Gninnorg/Gninnorg-Mezmerize-B1-ESP32-Controller/hardware/3D-front.jpg

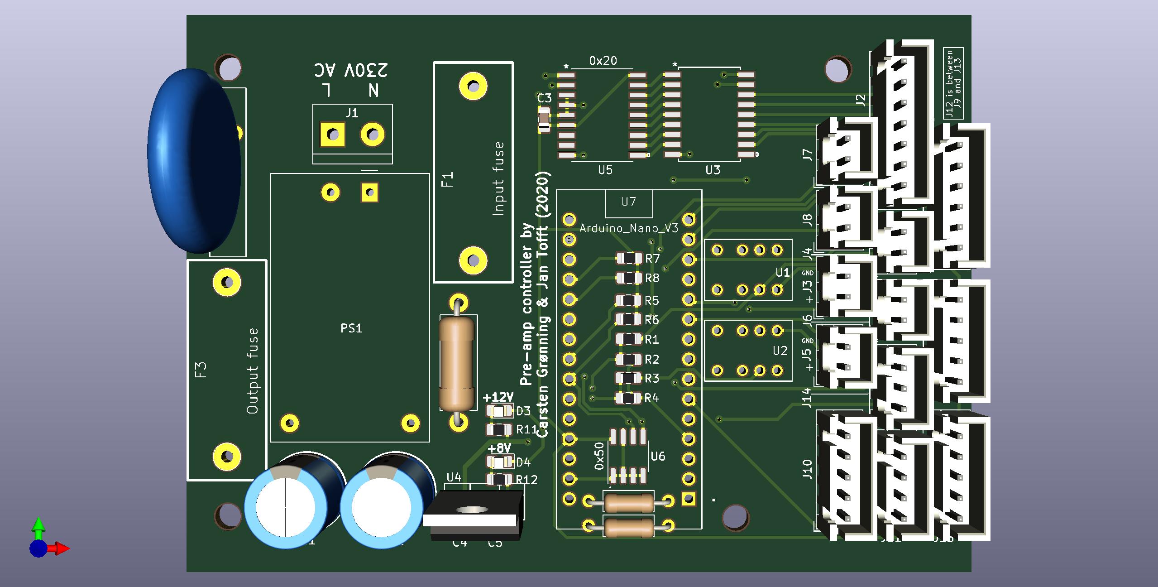
hardware/3D-front.jpg
