Gninnorg/Gninnorg-Mezmerize-B1-ESP32-Controller/hardware/3D-back.jpg

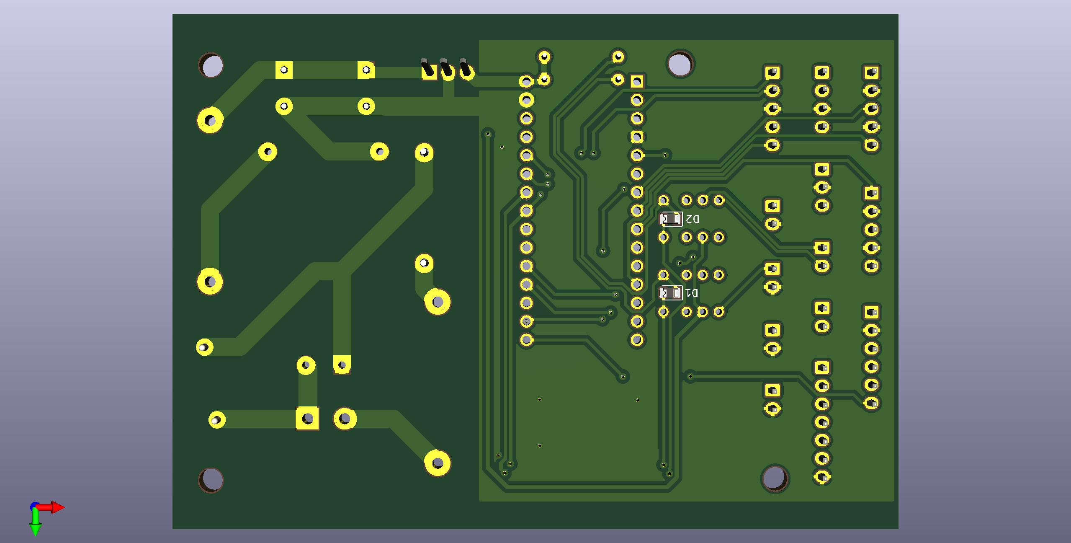
hardware/3D-back.jpg
