Gninnorg/Gninnorg-Mezmerize-B1-ESP32-Controller/hardware/BOM.xlsx

ref | value5 | footprint
C1 | 470uF | Capacitor_THT:CP_Radial_D10.0mm_P5.00mm
C2 | 470uF | Capacitor_THT:CP_Radial_D10.0mm_P5.00mm
C3 | 0.1uF | Capacitor_SMD:C_0805_2012Metric_Pad1.15x1.40mm_HandSolder
C4 | 0.33uF | Capacitor_SMD:C_0805_2012Metric_Pad1.15x1.40mm_HandSolder
C5 | 0.1uF | Capacitor_SMD:C_0805_2012Metric_Pad1.15x1.40mm_HandSolder
F1 | Fuse 200mA | Fuse:Fuseholder_Cylinder-5x20mm_Schurter_0031_8201_Horizontal_Open
F2 | Thermal fuse 73dgr | Resistor_THT:R_Axial_DIN0414_L11.9mm_D4.5mm_P15.24mm_Horizontal
F3 | Fuse 600mA T | Fuse:Fuseholder_Cylinder-5x20mm_Schurter_0031_8201_Horizontal_Open
J1 | 230 Vac | TerminalBlock:TerminalBlock_bornier-2_P5.08mm
J2 | B1 Relays | Connector_PinHeader_2.54mm:PinHeader_1x07_P2.54mm_Vertical
J3 | PWR AMP L 12V TRIGGER | Connector_PinHeader_2.54mm:PinHeader_1x02_P2.54mm_Vertical
J4 | PWR AMP L SWITCH | Connector_PinHeader_2.54mm:PinHeader_1x02_P2.54mm_Vertical
J5 | PWR AMP R 12V TRIGGER | Connector_PinHeader_2.54mm:PinHeader_1x02_P2.54mm_Vertical
J6 | PWR AMP R SWITCH | Connector_PinHeader_2.54mm:PinHeader_1x02_P2.54mm_Vertical
J7 | PWR AMP TEMP NTC L | Connector_PinHeader_2.54mm:PinHeader_1x02_P2.54mm_Vertical
J8 | PWR AMP TEMP NTC R | Connector_PinHeader_2.54mm:PinHeader_1x02_P2.54mm_Vertical
J9 | MUSES 72320 (SPI) | Connector_PinHeader_2.54mm:PinHeader_1x06_P2.54mm_Vertical
J10 | I2C DISPLAY (OLED/LCD) | Connector_PinHeader_2.54mm:PinHeader_1x05_P2.54mm_Vertical
J11 | I2C (FUTURE USE) | Connector_PinHeader_2.54mm:PinHeader_1x04_P2.54mm_Vertical
J12 | ROTARY ENC & SWITCH (FUTURE USE) | Connector_PinHeader_2.54mm:PinHeader_1x05_P2.54mm_Vertical
J13 | ROTARY ENC & SWITCH | Connector_PinHeader_2.54mm:PinHeader_1x05_P2.54mm_Vertical
J14 | IR RECV | Connector_PinHeader_2.54mm:PinHeader_1x03_P2.54mm_Vertical
PS1 | HLK-PM12 | Converter_ACDC:Converter_ACDC_HiLink_HLK-PMxx
R1 | 10K | Resistor_SMD:R_0805_2012Metric_Pad1.15x1.40mm_HandSolder
R2 | 5K | Resistor_SMD:R_0805_2012Metric_Pad1.15x1.40mm_HandSolder
R3 | 10K | Resistor_SMD:R_0805_2012Metric_Pad1.15x1.40mm_HandSolder
R4 | 5K | Resistor_SMD:R_0805_2012Metric_Pad1.15x1.40mm_HandSolder
R5 | 2K2 | Resistor_SMD:R_0805_2012Metric_Pad1.15x1.40mm_HandSolder
R6 | 2K2 | Resistor_SMD:R_0805_2012Metric_Pad1.15x1.40mm_HandSolder
R7 | 10K | Resistor_SMD:R_0805_2012Metric_Pad1.15x1.40mm_HandSolder
R8 | 10K | Resistor_SMD:R_0805_2012Metric_Pad1.15x1.40mm_HandSolder
R9 | R | Resistor_THT:R_Axial_DIN0207_L6.3mm_D2.5mm_P10.16mm_Horizontal
R10 | R | Resistor_THT:R_Axial_DIN0207_L6.3mm_D2.5mm_P10.16mm_Horizontal
RV1 | Varistor | Varistor:RV_Disc_D21.5mm_W4.6mm_P10mm
U1 | AGQ20T03 | AGQ20T03_footprint:AGQ20012
U2 | AGQ20T03 | AGQ20T03_footprint:AGQ20012
U3 | ULN2803ADWR | ULN2803:ULN2803ADWR
U4 | L7808CV | Package_TO_SOT_THT:TO-220-3_Vertical
U5 | MCP23008-E_SO | MCP23008:MCP23008-E&slash_SO
U6 | 24C02C_SN | Package_SO:SOIC-8-1EP_3.9x4.9mm_P1.27mm_EP2.41x3.3mm
U7 | Arduino_Nano_V3 | 0_Arduino_Nano_V3:ARDUINO_A000005
