Gninnorg/Gninnorg-Mezmerize-B1-ESP32-Controller/hardware/NTC measurement.xlsx

RESISTANCE | TEMP. (°C) | Calculated
7384 | 15 | 13.45761441
5872 | 20 | 19.27039403
4700 | 25 | 24.91858773
3786 | 30 | 30.40491253
3069 | 35 | 35.73155402
2502 | 40 | 40.91366482
2052 | 45 | 45.94391387
1691 | 50 | 50.8528784
1402 | 55 | 55.60773094
1167 | 60 | 60.26219829
977 | 65 | 64.77057364
821 | 70 | 69.18402871
694 | 75 | 73.44748636
