Gninnorg/Gninnorg-Mezmerize-B1-ESP32-Controller/hardware/Schematic Controller.pdf

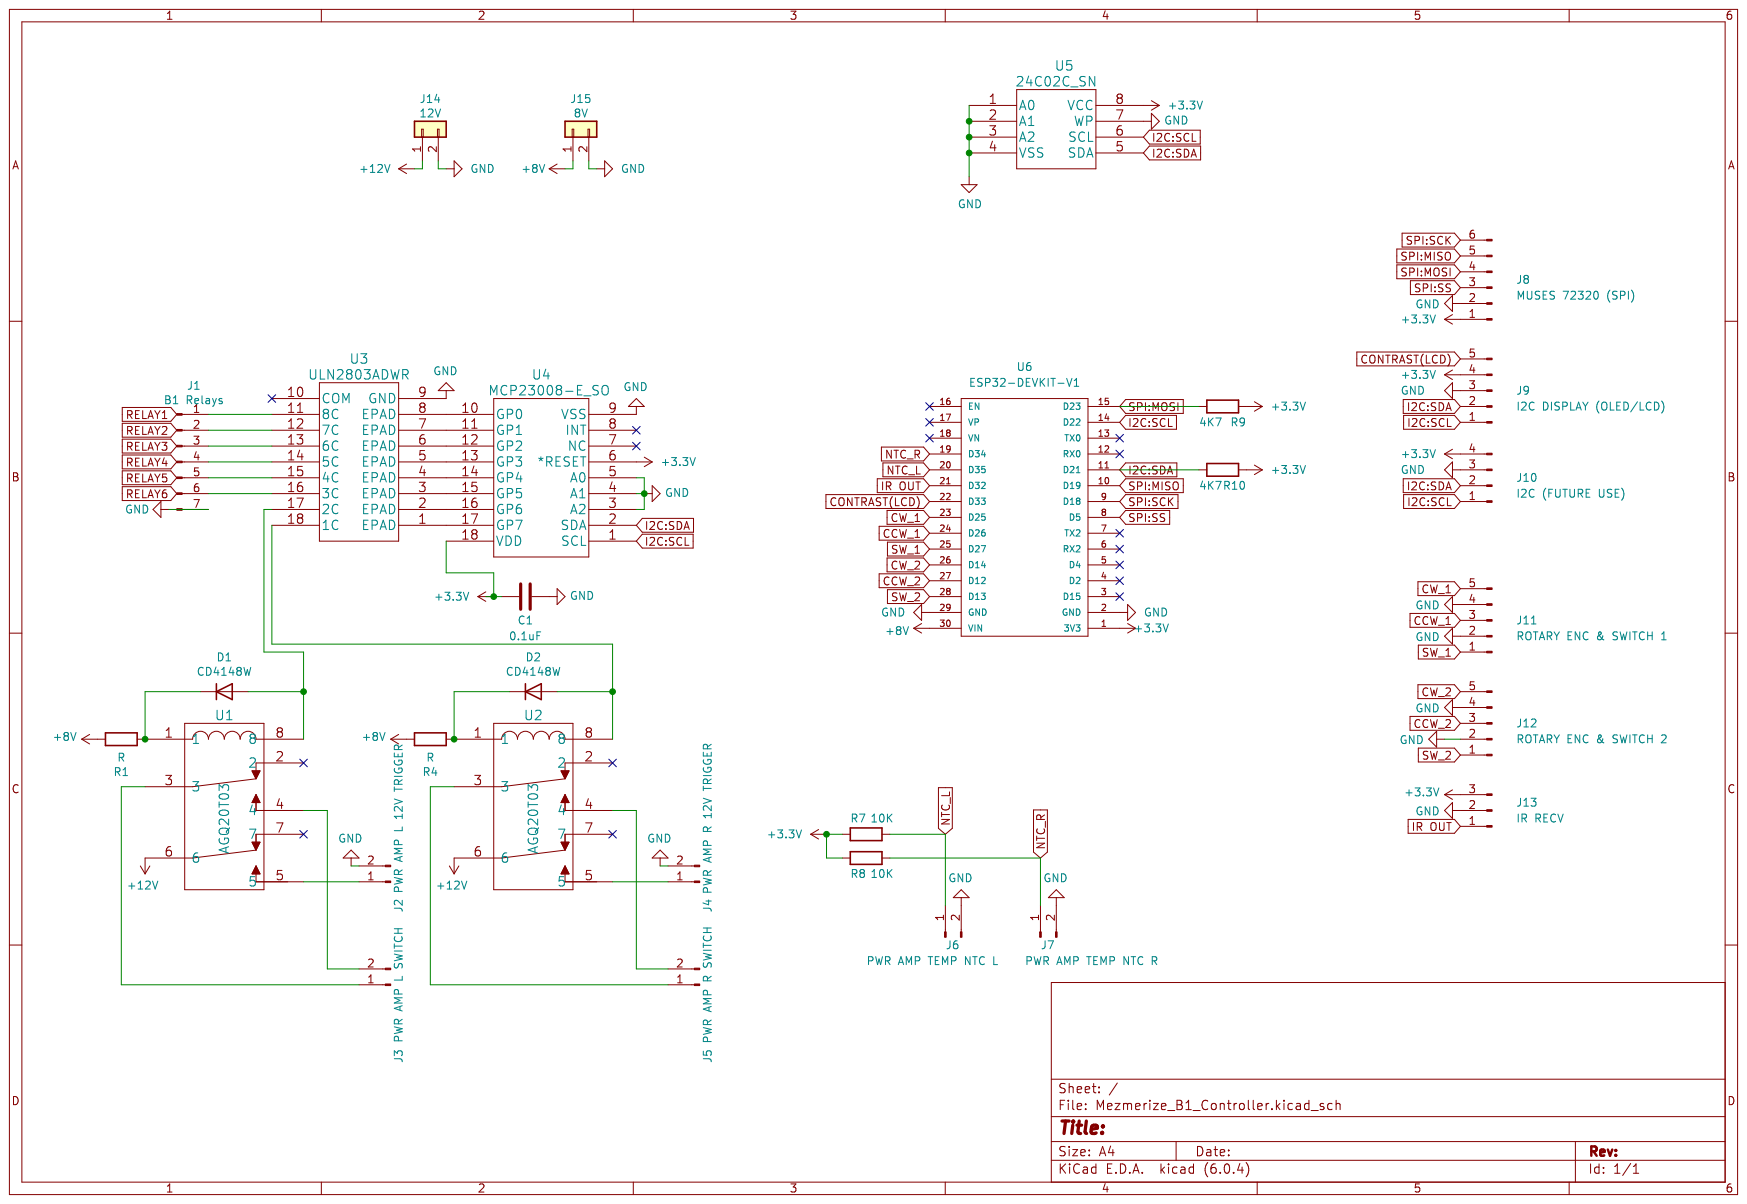
[picture p3: page 1]
