Gninnorg/Gninnorg-Mezmerize-B1-ESP32-Controller/hardware/Schematic PSU.pdf

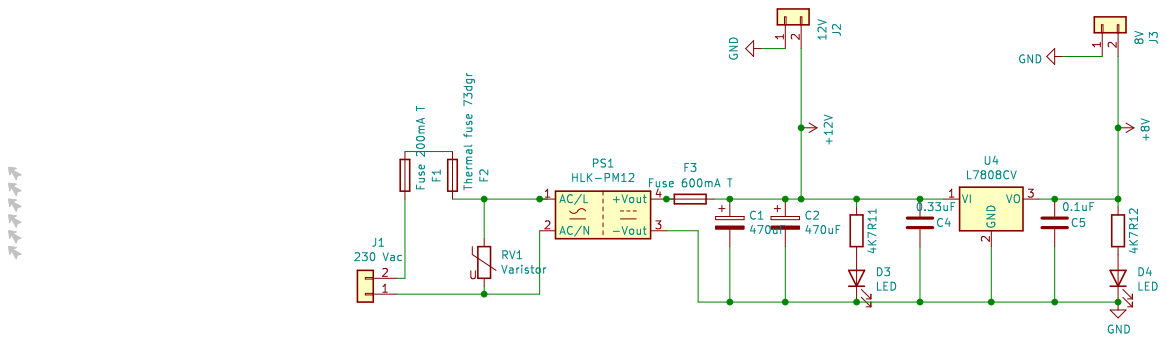
[picture p4: page 1]
