Gninnorg/Gninnorg-Mezmerize-B1-ESP32-Controller/hardware/PCB/Mezmerize_B1_Controller.kicad_pcb

## KiCad design hardware/PCB/Mezmerize_B1_Controller.kicad_pcb (2022-09-24)

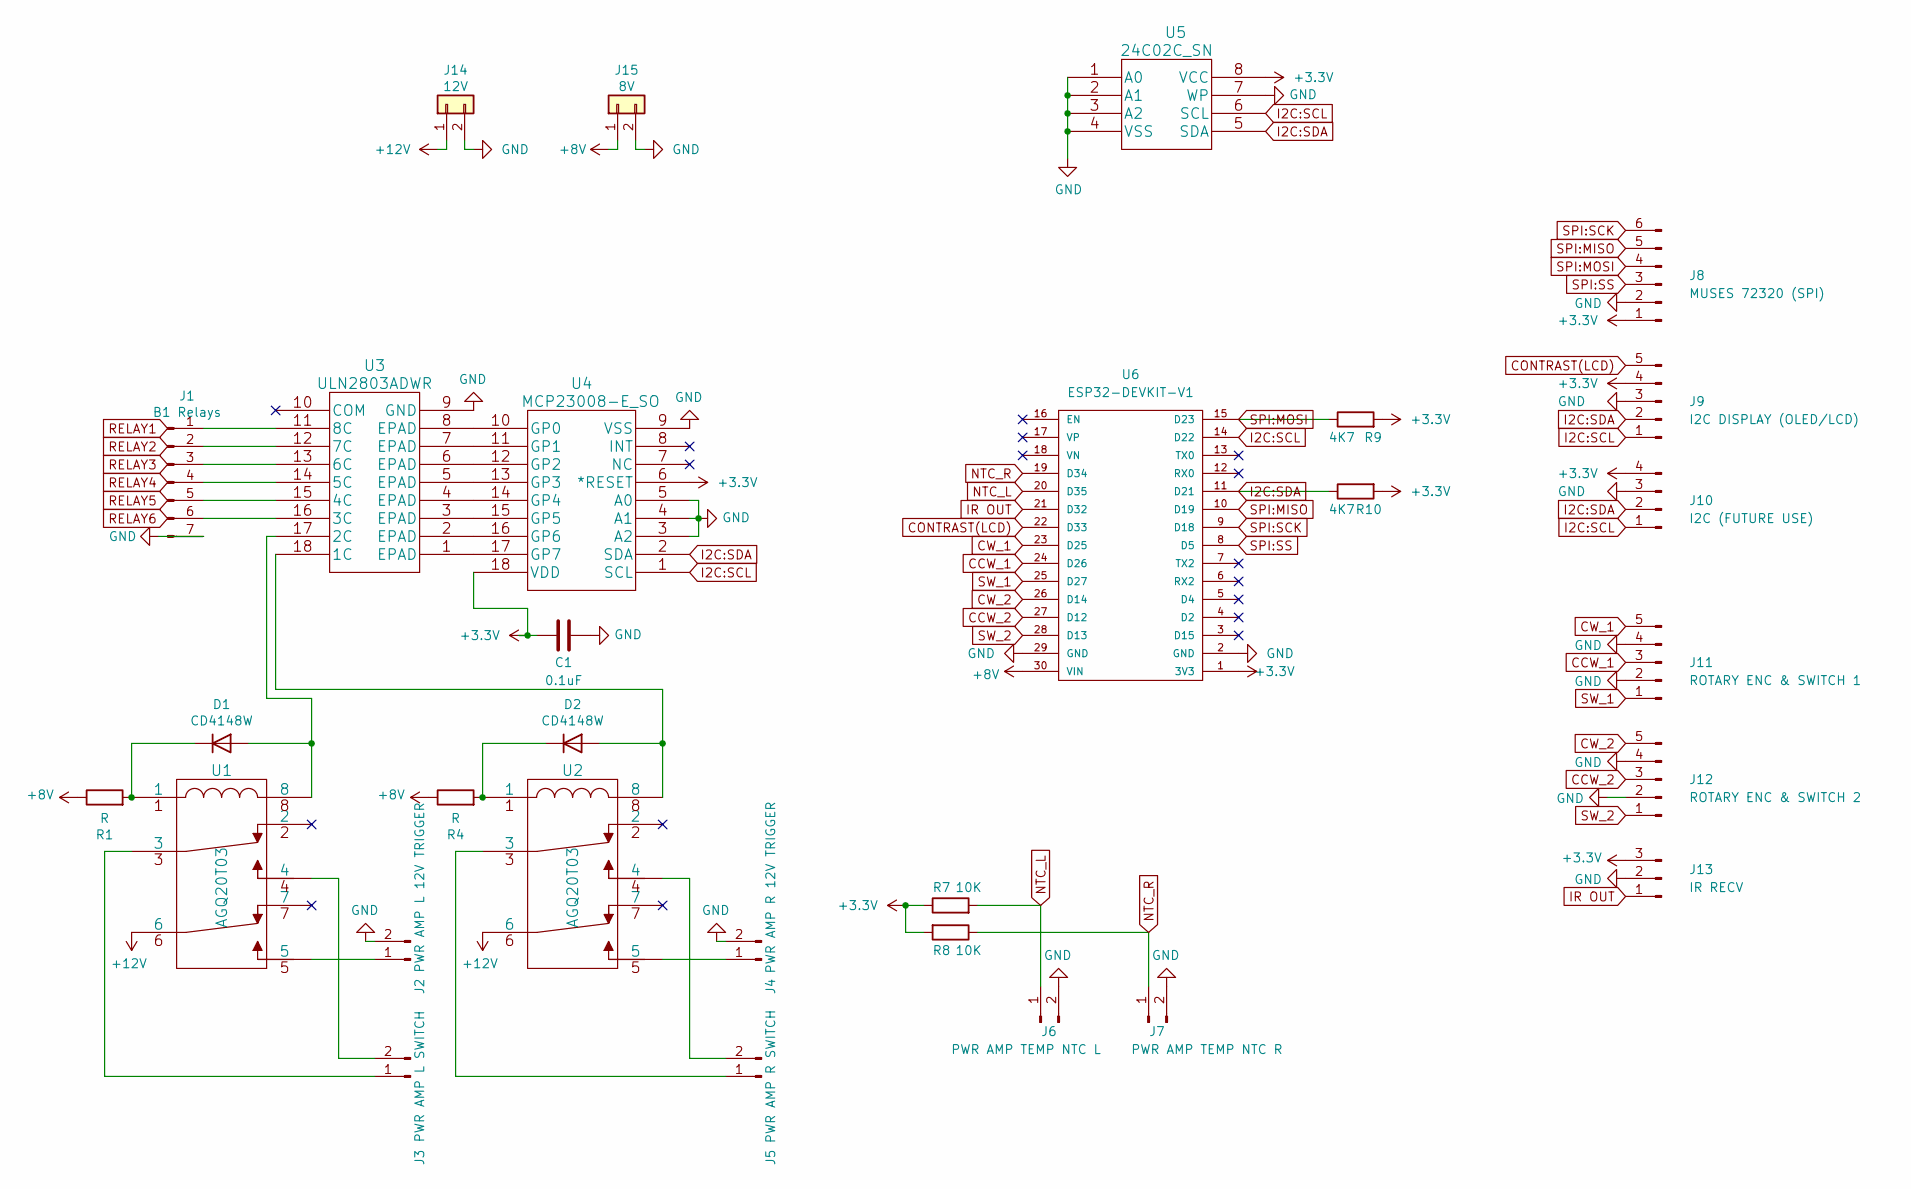
[picture p5: schematic Mezmerize_B1_Controller.kicad_sch]

Parts:
C1: 0.1uF; C_0805_2012Metric_Pad1.15x1.40mm_HandSolder
D1, D2: CD4148W; D_0805_2012Metric
J1: B1 Relays; JST_XH_B7B-XH-A_1x07_P2.50mm_Vertical
J2: PWR AMP L 12V TRIGGER; JST_XH_B2B-XH-A_1x02_P2.50mm_Vertical
J3: PWR AMP L SWITCH; JST_XH_B2B-XH-A_1x02_P2.50mm_Vertical
J4: PWR AMP R 12V TRIGGER; JST_XH_B2B-XH-A_1x02_P2.50mm_Vertical
J5: PWR AMP R SWITCH; JST_XH_B2B-XH-A_1x02_P2.50mm_Vertical
J6: PWR AMP TEMP NTC L; JST_XH_B2B-XH-A_1x02_P2.50mm_Vertical
J7: PWR AMP TEMP NTC R; JST_XH_B2B-XH-A_1x02_P2.50mm_Vertical
J8: MUSES 72320 (SPI); JST_XH_B6B-XH-A_1x06_P2.50mm_Vertical
J9: I2C DISPLAY (OLED/LCD); JST_XH_B5B-XH-A_1x05_P2.50mm_Vertical
J10: I2C (FUTURE USE); JST_XH_B4B-XH-A_1x04_P2.50mm_Vertical
J11: ROTARY ENC & SWITCH 1; JST_XH_B5B-XH-A_1x05_P2.50mm_Vertical
J12: ROTARY ENC & SWITCH 2; JST_XH_B5B-XH-A_1x05_P2.50mm_Vertical
J13: IR RECV; JST_XH_B3B-XH-A_1x03_P2.50mm_Vertical
J14: 12V; TerminalBlock_bornier-2_P5.08mm
J15: 8V; TerminalBlock_bornier-2_P5.08mm
R1, R4: R; R_Axial_DIN0207_L6.3mm_D2.5mm_P10.16mm_Horizontal
R7, R8: 10K; R_0805_2012Metric_Pad1.15x1.40mm_HandSolder
R9, R10: 4K7; R_0805_2012Metric_Pad1.15x1.40mm_HandSolder
U1, U2: AGQ20T03; AGQ20012
U3: ULN2803ADWR
U4: MCP23008-E_SO; MCP23008-E&slash_SO
U5: 24C02C_SN; SOIC-8-1EP_3.9x4.9mm_P1.27mm_EP2.41x3.3mm
U6: ESP32-DEVKIT-V1; MODULE_ESP32_DEVKIT_V1; PARTREV N/A

Connections:
+3V3: C1.1, J8.1, J9.4, J10.4, J13.3, R7.1, R8.2, R9.2, R10.2, U4.6 (*RESET), U4.18 (VDD), U5.8 (VCC), U6.1 (3V3)
+8V: J15.1, R1.1, R4.1, U6.30 (VIN)
+12V: J14.1, U1.6, U2.6
CCW_1: J11.3, U6.24 (D26)
CCW_2: J12.3, U6.27 (D12)
CONTRAST(LCD): J9.5, U6.22 (D33)
CW_1: J11.5, U6.23 (D25)
CW_2: J12.5, U6.26 (D14)
GND: C1.2, J1.7, J2.2, J4.2, J6.2, J7.2, J8.2, J9.3, J10.3, J11.2, J11.4, J12.2, J12.4, J13.2, J14.2, J15.2, U3.9 (GND), U4.3 (A2), U4.4 (A1), U4.5 (A0), U4.9 (VSS), U5.1 (A0), U5.2 (A1), U5.3 (A2), U5.4 (VSS), U5.7 (WP), U6.2 (GND), U6.29 (GND)
I2C:SCL: J9.1, J10.1, U4.1 (SCL), U5.6 (SCL), U6.14 (D22)
I2C:SDA: J9.2, J10.2, R10.1, U4.2 (SDA), U5.5 (SDA), U6.11 (D21)
IR OUT: J13.1, U6.21 (D32)
NTC_L: J6.1, R7.2, U6.20 (D35)
NTC_R: J7.1, R8.1, U6.19 (D34)
unnamed: D1.1 (K), R1.2, U1.1
unnamed: D1.2 (A), U1.8, U3.17 (2C)
unnamed: D2.1 (K), R4.2, U2.1
unnamed: D2.2 (A), U2.8, U3.18 (1C)
unnamed: J1.1, U3.11 (8C)
unnamed: J1.2, U3.12 (7C)
unnamed: J1.3, U3.13 (6C)
unnamed: J1.4, U3.14 (5C)
unnamed: J1.5, U3.15 (4C)
unnamed: J1.6, U3.16 (3C)
unnamed: J2.1, U1.5
unnamed: J3.1, U1.3
unnamed: J3.2, U1.4
unnamed: J4.1, U2.5
unnamed: J5.1, U2.3
unnamed: J5.2, U2.4
unnamed: U3.1 (EPAD), U4.17 (GP7)
unnamed: U3.2 (EPAD), U4.16 (GP6)
unnamed: U3.3 (EPAD), U4.15 (GP5)
unnamed: U3.4 (EPAD), U4.14 (GP4)
unnamed: U3.5 (EPAD), U4.13 (GP3)
unnamed: U3.6 (EPAD), U4.12 (GP2)
unnamed: U3.7 (EPAD), U4.11 (GP1)
unnamed: U3.8 (EPAD), U4.10 (GP0)
SPI:MISO: J8.5, U6.10 (D19)
SPI:MOSI: J8.4, R9.1, U6.15 (D23)
SPI:SCK: J8.6, U6.9 (D18)
SPI:SS: J8.3, U6.8 (D5)
SW_1: J11.1, U6.25 (D27)
SW_2: J12.1, U6.28 (D13)

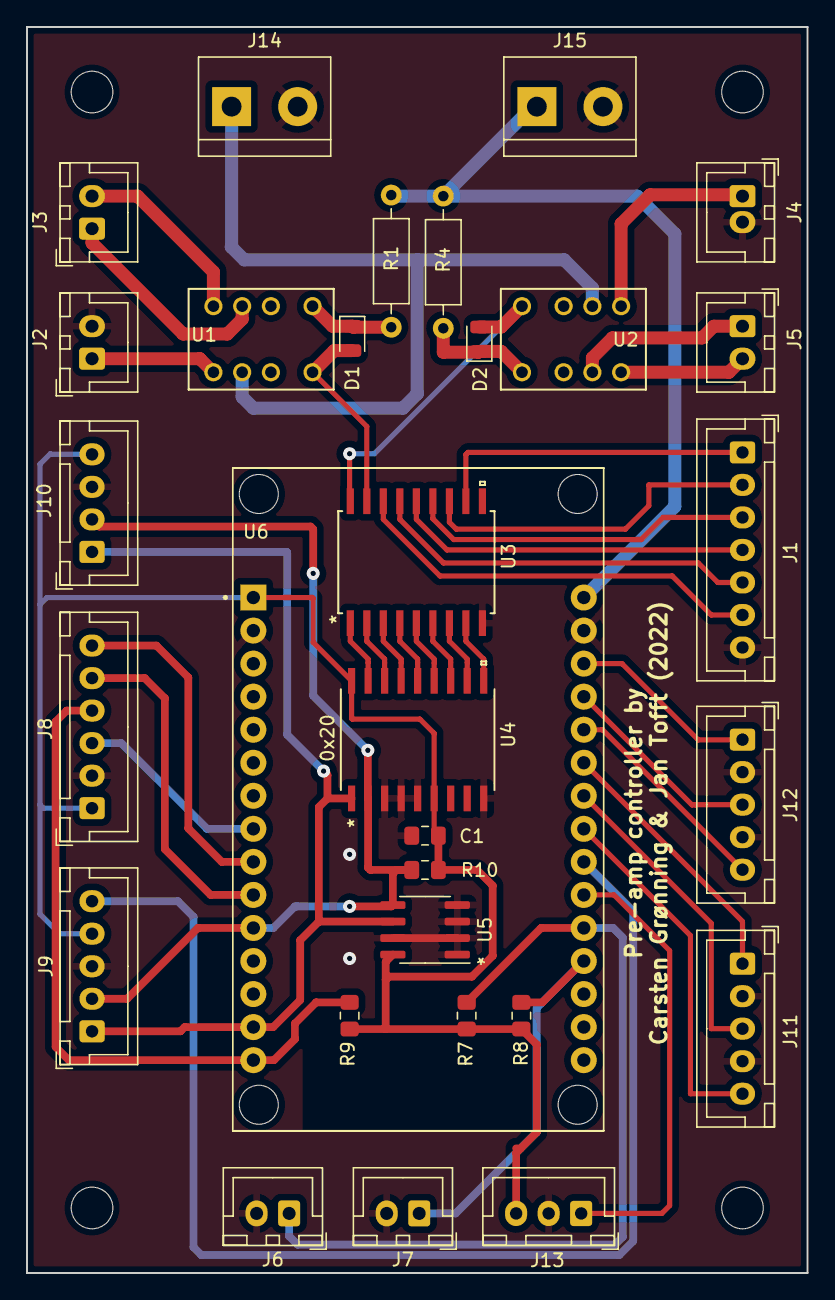
[picture p6: board Mezmerize_B1_Controller.kicad_pcb from above]

Board: 2 copper layers, 60.0 x 95.8 mm, 30 parts (0 on the bottom side), 44 nets.
