Gninnorg/Gninnorg-Mezmerize-B1-ESP32-Controller/hardware/Power Supply/Power Supply.kicad_pcb

## KiCad design hardware/Power Supply/Power Supply.kicad_pcb (2022-06-01)

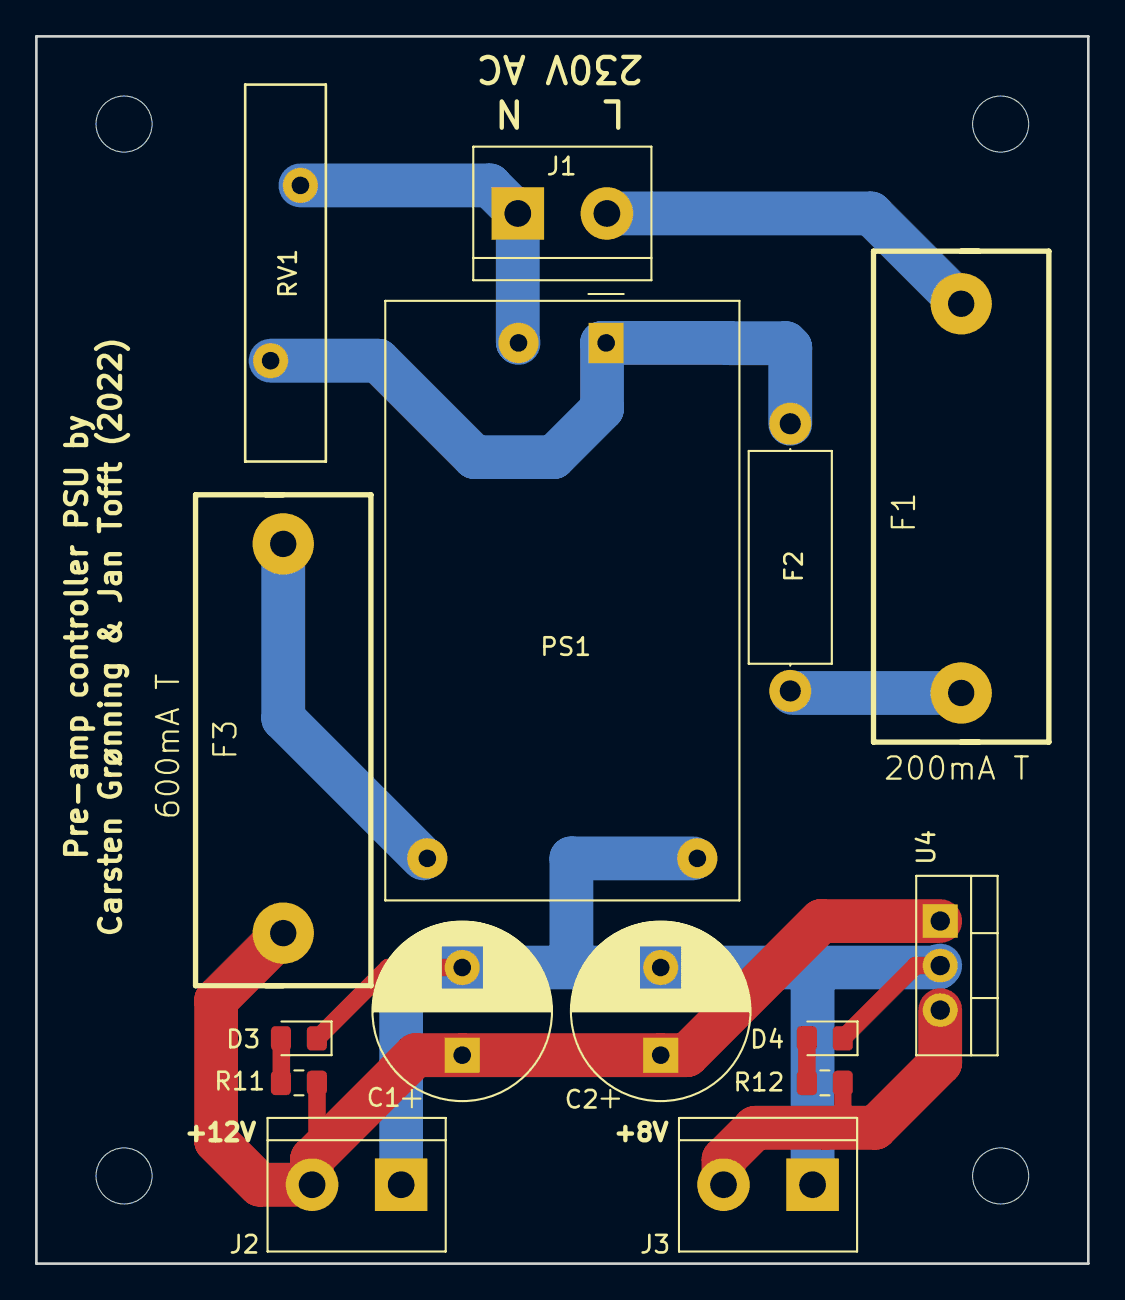
[picture p7: board Power Supply.kicad_pcb from above]

Board: 2 copper layers, 60.0 x 70.0 mm, 15 parts (0 on the bottom side), 10 nets.

Parts:
C1, C2: 470uF; CP_Radial_D10.0mm_P5.00mm
D3, D4: LED; LED_0805_2012Metric_Pad1.15x1.40mm_HandSolder
F1: 200mA T; BLX-A
F2: Thermal fuse 73dgr; R_Axial_DIN0414_L11.9mm_D4.5mm_P15.24mm_Horizontal
F3: 600mA T; BLX-A
J1: 230 Vac; TerminalBlock_bornier-2_P5.08mm
J2: 12V; TerminalBlock_bornier-2_P5.08mm
J3: 8V; TerminalBlock_bornier-2_P5.08mm
PS1: HLK-PM12; Converter_ACDC_HiLink_HLK-PMxx
R11, R12: 4K7; R_0805_2012Metric_Pad1.15x1.40mm_HandSolder
RV1: Varistor; RV_Disc_D21.5mm_W4.6mm_P10mm
U4: L7808CV; TO-220-3_Vertical

Connections:
+8V: J3.2, R12.2, U4.3 (VO)
+12V: C1.1, C2.1, F3.1, J2.2, R11.2, U4.1 (VI)
GND: C1.2, C2.2, D3.1 (K), D4.1 (K), J2.1, J3.1, PS1.3 (-Vout), U4.2 (GND)
unnamed: D3.2 (A), R11.1
unnamed: D4.2 (A), R12.1
unnamed: F1.1, J1.2
unnamed: F1.2, F2.1
unnamed: F2.2, PS1.1 (AC/L), RV1.1
unnamed: F3.2, PS1.4 (+Vout)
unnamed: J1.1, PS1.2 (AC/N), RV1.2
