Gninnorg/Gninnorg-Mezmerize-B1-ESP32-Controller/src/MenuData.h

#ifndef _ctlMenu_
#define _ctlMenu_
#include "MenuManager.h"

/*

Generated using LCD Menu Builder at https://lcd-menu-bulder.cohesivecomputing.co.uk/
For more information, visit https://www.cohesivecomputing.co.uk/hackatronics/arduino-lcd-menu-library/

All our hackatronics projects are free for personal use. If you find them helpful or useful, please consider
making a small donation to our hackatronics fund using the donate buttons on our web pages. Thank you.
		
*/

enum ctlMenuCommandId
{
  mnuCmdBack = 0,
  mnuCmdVOLUME_MENU,
  mnuCmdVOL_STEPS,
  mnuCmdMIN_ATT,
  mnuCmdMAX_ATT,
  mnuCmdMAX_START_VOL,
  mnuCmdMUTE_LVL,
  mnuCmdSTORE_LVL,
  mnuCmdINPUT_MENU,
  mnuCmdINPUT1_MENU,
  mnuCmdINPUT1_ACTIVE,
  mnuCmdINPUT1_NAME,
  mnuCmdINPUT1_MAX_VOL,
  mnuCmdINPUT1_MIN_VOL,
  mnuCmdINPUT2_MENU,
  mnuCmdINPUT2_ACTIVE,
  mnuCmdINPUT2_NAME,
  mnuCmdINPUT2_MAX_VOL,
  mnuCmdINPUT2_MIN_VOL,
  mnuCmdINPUT3_MENU,
  mnuCmdINPUT3_ACTIVE,
  mnuCmdINPUT3_NAME,
  mnuCmdINPUT3_MAX_VOL,
  mnuCmdINPUT3_MIN_VOL,
  mnuCmdINPUT4_MENU,
  mnuCmdINPUT4_ACTIVE,
  mnuCmdINPUT4_NAME,
  mnuCmdINPUT4_MAX_VOL,
  mnuCmdINPUT4_MIN_VOL,
  mnuCmdINPUT5_MENU,
  mnuCmdINPUT5_ACTIVE,
  mnuCmdINPUT5_NAME,
  mnuCmdINPUT5_MAX_VOL,
  mnuCmdINPUT5_MIN_VOL,
  mnuCmdINPUT6_MENU,
  mnuCmdINPUT6_ACTIVE,
  mnuCmdINPUT6_NAME,
  mnuCmdINPUT6_MAX_VOL,
  mnuCmdINPUT6_MIN_VOL,
  mnuCmdIR_MENU,
  mnuCmdIR_ONOFF,
  mnuCmdIR_UP,
  mnuCmdIR_DOWN,
  mnuCmdIR_REPEAT,
  mnuCmdIR_LEFT,
  mnuCmdIR_RIGHT,
  mnuCmdIR_SELECT,
  mnuCmdIR_BACK,
  mnuCmdIR_MUTE,
  mnuCmdIR_PREV,
  mnuCmdIR_1,
  mnuCmdIR_2,
  mnuCmdIR_3,
  mnuCmdIR_4,
  mnuCmdIR_5,
  mnuCmdIR_6,
  mnuCmdPWR_CTL_MENU,
  mnuCmdTRIG1_MENU,
  mnuCmdTRIGGER1_ACTIVE,
  mnuCmdTRIGGER1_TYPE,
  mnuCmdTRIGGER1_ON_DELAY,
  mnuCmdTRIGGER1_TEMP,
  mnuCmdTRIG2_MENU,
  mnuCmdTRIGGER2_ACTIVE,
  mnuCmdTRIGGER2_TYPE,
  mnuCmdTRIGGER2_ON_DELAY,
  mnuCmdTRIGGER2_TEMP,
  mnuCmdTRIGGER_INACT_TIMER,
  mnuCmdDISP_MENU,
  mnuCmdDISP_SAVER_ACTIVE,
  mnuCmdDISP_ON_LEVEL,
  mnuCmdDISP_DIM_LEVEL,
  mnuCmdDISP_DIM_TIMEOUT,
  mnuCmdDISP_VOL,
  mnuCmdDISP_INPUT,
  mnuCmdDISP_TEMP1,
  mnuCmdDISP_TEMP2,
  mnuCmdABOUT,
  mnuCmdRESET_MENU,
  mnuCmdSAVE_CUST,
  mnuCmdLOAD_CUST,
  mnuCmdLOAD_DEFAULT
};

const char ctlMenu_back[] = "Back";
const char ctlMenu_exit[] = "Exit";

const char ctlMenu_2_1_1[] = "Active";
const char ctlMenu_2_1_2[] = "Name";
const char ctlMenu_2_1_3[] = "Max. volume";
const char ctlMenu_2_1_4[] = "Min. volume";
const MenuItem ctlMenu_List_2_1[] = {{mnuCmdINPUT1_ACTIVE, ctlMenu_2_1_1}, {mnuCmdINPUT1_NAME, ctlMenu_2_1_2}, {mnuCmdINPUT1_MAX_VOL, ctlMenu_2_1_3}, {mnuCmdINPUT1_MIN_VOL, ctlMenu_2_1_4}, {mnuCmdBack, ctlMenu_back}};

const char ctlMenu_2_2_1[] = "Active";
const char ctlMenu_2_2_2[] = "Name";
const char ctlMenu_2_2_3[] = "Max. volume";
const char ctlMenu_2_2_4[] = "Min. volume";
const MenuItem ctlMenu_List_2_2[] = {{mnuCmdINPUT2_ACTIVE, ctlMenu_2_2_1}, {mnuCmdINPUT2_NAME, ctlMenu_2_2_2}, {mnuCmdINPUT2_MAX_VOL, ctlMenu_2_2_3}, {mnuCmdINPUT2_MIN_VOL, ctlMenu_2_2_4}, {mnuCmdBack, ctlMenu_back}};

const char ctlMenu_2_3_1[] = "Active";
const char ctlMenu_2_3_2[] = "Name";
const char ctlMenu_2_3_3[] = "Max. volume";
const char ctlMenu_2_3_4[] = "Min. volume";
const MenuItem ctlMenu_List_2_3[] = {{mnuCmdINPUT3_ACTIVE, ctlMenu_2_3_1}, {mnuCmdINPUT3_NAME, ctlMenu_2_3_2}, {mnuCmdINPUT3_MAX_VOL, ctlMenu_2_3_3}, {mnuCmdINPUT3_MIN_VOL, ctlMenu_2_3_4}, {mnuCmdBack, ctlMenu_back}};

const char ctlMenu_2_4_1[] = "Active";
const char ctlMenu_2_4_2[] = "Name";
const char ctlMenu_2_4_3[] = "Max. volume";
const char ctlMenu_2_4_4[] = "Min. volume";
const MenuItem ctlMenu_List_2_4[] = {{mnuCmdINPUT4_ACTIVE, ctlMenu_2_4_1}, {mnuCmdINPUT4_NAME, ctlMenu_2_4_2}, {mnuCmdINPUT4_MAX_VOL, ctlMenu_2_4_3}, {mnuCmdINPUT4_MIN_VOL, ctlMenu_2_4_4}, {mnuCmdBack, ctlMenu_back}};

const char ctlMenu_2_5_1[] = "Active";
const char ctlMenu_2_5_2[] = "Name";
const char ctlMenu_2_5_3[] = "Max. volume";
const char ctlMenu_2_5_4[] = "Min. volume";
const MenuItem ctlMenu_List_2_5[] = {{mnuCmdINPUT5_ACTIVE, ctlMenu_2_5_1}, {mnuCmdINPUT5_NAME, ctlMenu_2_5_2}, {mnuCmdINPUT5_MAX_VOL, ctlMenu_2_5_3}, {mnuCmdINPUT5_MIN_VOL, ctlMenu_2_5_4}, {mnuCmdBack, ctlMenu_back}};

const char ctlMenu_2_6_1[] = "Active";
const char ctlMenu_2_6_2[] = "Name";
const char ctlMenu_2_6_3[] = "Max. volume";
const char ctlMenu_2_6_4[] = "Min. volume";
const MenuItem ctlMenu_List_2_6[] = {{mnuCmdINPUT6_ACTIVE, ctlMenu_2_6_1}, {mnuCmdINPUT6_NAME, ctlMenu_2_6_2}, {mnuCmdINPUT6_MAX_VOL, ctlMenu_2_6_3}, {mnuCmdINPUT6_MIN_VOL, ctlMenu_2_6_4}, {mnuCmdBack, ctlMenu_back}};

const char ctlMenu_4_1_1[] = "Active";
const char ctlMenu_4_1_2[] = "Moment./Latch";
const char ctlMenu_4_1_3[] = "On delay";
const char ctlMenu_4_1_4[] = "Temp control";
const MenuItem ctlMenu_List_4_1[] = {{mnuCmdTRIGGER1_ACTIVE, ctlMenu_4_1_1}, {mnuCmdTRIGGER1_TYPE, ctlMenu_4_1_2}, {mnuCmdTRIGGER1_ON_DELAY, ctlMenu_4_1_3}, {mnuCmdTRIGGER1_TEMP, ctlMenu_4_1_4}, {mnuCmdBack, ctlMenu_back}};

const char ctlMenu_4_2_1[] = "Active";
const char ctlMenu_4_2_2[] = "Moment./Latch";
const char ctlMenu_4_2_3[] = "On delay";
const char ctlMenu_4_2_4[] = "Temp control";
const MenuItem ctlMenu_List_4_2[] = {{mnuCmdTRIGGER2_ACTIVE, ctlMenu_4_2_1}, {mnuCmdTRIGGER2_TYPE, ctlMenu_4_2_2}, {mnuCmdTRIGGER2_ON_DELAY, ctlMenu_4_2_3}, {mnuCmdTRIGGER2_TEMP, ctlMenu_4_2_4}, {mnuCmdBack, ctlMenu_back}};

const char ctlMenu_1_1[] = "Volume steps";
const char ctlMenu_1_2[] = "Min attenuation";
const char ctlMenu_1_3[] = "Max attenuation";
const char ctlMenu_1_4[] = "Max start vol";
const char ctlMenu_1_5[] = "Mute level";
const char ctlMenu_1_6[] = "Vol. memory";
const MenuItem ctlMenu_List_1[] = {{mnuCmdVOL_STEPS, ctlMenu_1_1}, {mnuCmdMIN_ATT, ctlMenu_1_2}, {mnuCmdMAX_ATT, ctlMenu_1_3}, {mnuCmdMAX_START_VOL, ctlMenu_1_4}, {mnuCmdMUTE_LVL, ctlMenu_1_5}, {mnuCmdSTORE_LVL, ctlMenu_1_6}, {mnuCmdBack, ctlMenu_back}};

const char ctlMenu_2_1[] = "Input 1";
const char ctlMenu_2_2[] = "Input 2";
const char ctlMenu_2_3[] = "Input 3";
const char ctlMenu_2_4[] = "Input 4";
const char ctlMenu_2_5[] = "Input 5";
const char ctlMenu_2_6[] = "Input 6";
const MenuItem ctlMenu_List_2[] = {{mnuCmdINPUT1_MENU, ctlMenu_2_1, ctlMenu_List_2_1, menuCount(ctlMenu_List_2_1)}, {mnuCmdINPUT2_MENU, ctlMenu_2_2, ctlMenu_List_2_2, menuCount(ctlMenu_List_2_2)}, {mnuCmdINPUT3_MENU, ctlMenu_2_3, ctlMenu_List_2_3, menuCount(ctlMenu_List_2_3)}, {mnuCmdINPUT4_MENU, ctlMenu_2_4, ctlMenu_List_2_4, menuCount(ctlMenu_List_2_4)}, {mnuCmdINPUT5_MENU, ctlMenu_2_5, ctlMenu_List_2_5, menuCount(ctlMenu_List_2_5)}, {mnuCmdINPUT6_MENU, ctlMenu_2_6, ctlMenu_List_2_6, menuCount(ctlMenu_List_2_6)}, {mnuCmdBack, ctlMenu_back}};

const char ctlMenu_3_1[] = "On/Off";
const char ctlMenu_3_2[] = "Up";
const char ctlMenu_3_3[] = "Down";
const char ctlMenu_3_4[] = "Repeat";
const char ctlMenu_3_5[] = "Left";
const char ctlMenu_3_6[] = "Right";
const char ctlMenu_3_7[] = "Select";
const char ctlMenu_3_8[] = "Back";
const char ctlMenu_3_9[] = "Mute";
const char ctlMenu_3_10[] = "Previous";
const char ctlMenu_3_11[] = "1";
const char ctlMenu_3_12[] = "2";
const char ctlMenu_3_13[] = "3";
const char ctlMenu_3_14[] = "4";
const char ctlMenu_3_15[] = "5";
const char ctlMenu_3_16[] = "6";
const MenuItem ctlMenu_List_3[] = {{mnuCmdIR_ONOFF, ctlMenu_3_1}, {mnuCmdIR_UP, ctlMenu_3_2}, {mnuCmdIR_DOWN, ctlMenu_3_3}, {mnuCmdIR_REPEAT, ctlMenu_3_4}, {mnuCmdIR_LEFT, ctlMenu_3_5}, {mnuCmdIR_RIGHT, ctlMenu_3_6}, {mnuCmdIR_SELECT, ctlMenu_3_7}, {mnuCmdIR_BACK, ctlMenu_3_8}, {mnuCmdIR_MUTE, ctlMenu_3_9}, {mnuCmdIR_PREV, ctlMenu_3_10}, {mnuCmdIR_1, ctlMenu_3_11}, {mnuCmdIR_2, ctlMenu_3_12}, {mnuCmdIR_3, ctlMenu_3_13}, {mnuCmdIR_4, ctlMenu_3_14}, {mnuCmdIR_5, ctlMenu_3_15}, {mnuCmdIR_6, ctlMenu_3_16}, {mnuCmdBack, ctlMenu_back}};

const char ctlMenu_4_1[] = "Trigger 1";
const char ctlMenu_4_2[] = "Trigger 2";
const char ctlMenu_4_3[] = "Standby timer";
const MenuItem ctlMenu_List_4[] = {{mnuCmdTRIG1_MENU, ctlMenu_4_1, ctlMenu_List_4_1, menuCount(ctlMenu_List_4_1)}, {mnuCmdTRIG2_MENU, ctlMenu_4_2, ctlMenu_List_4_2, menuCount(ctlMenu_List_4_2)}, {mnuCmdTRIGGER_INACT_TIMER, ctlMenu_4_3}, {mnuCmdBack, ctlMenu_back}};

const char ctlMenu_5_1[] = "Screen saver";
const char ctlMenu_5_2[] = "On Level";
const char ctlMenu_5_3[] = "Dim Level";
const char ctlMenu_5_4[] = "Timeout";
const char ctlMenu_5_5[] = "Volume display";
const char ctlMenu_5_6[] = "Input display";
const char ctlMenu_5_7[] = "Temp 1 display";
const char ctlMenu_5_8[] = "Temp 2 display";
const MenuItem ctlMenu_List_5[] = {{mnuCmdDISP_SAVER_ACTIVE, ctlMenu_5_1}, {mnuCmdDISP_ON_LEVEL, ctlMenu_5_2}, {mnuCmdDISP_DIM_LEVEL, ctlMenu_5_3}, {mnuCmdDISP_DIM_TIMEOUT, ctlMenu_5_4}, {mnuCmdDISP_VOL, ctlMenu_5_5}, {mnuCmdDISP_INPUT, ctlMenu_5_6}, {mnuCmdDISP_TEMP1, ctlMenu_5_7}, {mnuCmdDISP_TEMP2, ctlMenu_5_8}, {mnuCmdBack, ctlMenu_back}};

const char ctlMenu_7_1[] = "Save user setup";
const char ctlMenu_7_2[] = "Load user setup";
const char ctlMenu_7_3[] = "Factory reset";
const MenuItem ctlMenu_List_7[] = {{mnuCmdSAVE_CUST, ctlMenu_7_1}, {mnuCmdLOAD_CUST, ctlMenu_7_2}, {mnuCmdLOAD_DEFAULT, ctlMenu_7_3}, {mnuCmdBack, ctlMenu_back}};

const char ctlMenu_1[] = "Volume";
const char ctlMenu_2[] = "Inputs";
const char ctlMenu_3[] = "Learn IR";
const char ctlMenu_4[] = "Triggers";
const char ctlMenu_5[] = "Display";
const char ctlMenu_6[] = "About";
const char ctlMenu_7[] = "Save/load/reset";
const MenuItem ctlMenu_Root[] = {{mnuCmdVOLUME_MENU, ctlMenu_1, ctlMenu_List_1, menuCount(ctlMenu_List_1)}, {mnuCmdINPUT_MENU, ctlMenu_2, ctlMenu_List_2, menuCount(ctlMenu_List_2)}, {mnuCmdIR_MENU, ctlMenu_3, ctlMenu_List_3, menuCount(ctlMenu_List_3)}, {mnuCmdPWR_CTL_MENU, ctlMenu_4, ctlMenu_List_4, menuCount(ctlMenu_List_4)}, {mnuCmdDISP_MENU, ctlMenu_5, ctlMenu_List_5, menuCount(ctlMenu_List_5)}, {mnuCmdABOUT, ctlMenu_6}, {mnuCmdRESET_MENU, ctlMenu_7, ctlMenu_List_7, menuCount(ctlMenu_List_7)}, {mnuCmdBack, ctlMenu_exit}};

/*
case mnuCmdVOL_STEPS :
	break;
case mnuCmdMIN_ATT :
	break;
case mnuCmdMAX_ATT :
	break;
case mnuCmdMAX_START_VOL :
	break;
case mnuCmdMUTE_LVL :
	break;
case mnuCmdSTORE_LVL :
	break;
case mnuCmdINPUT1_ACTIVE :
	break;
case mnuCmdINPUT1_NAME :
	break;
case mnuCmdINPUT1_MAX_VOL :
	break;
case mnuCmdINPUT1_MIN_VOL :
	break;
case mnuCmdINPUT2_ACTIVE :
	break;
case mnuCmdINPUT2_NAME :
	break;
case mnuCmdINPUT2_MAX_VOL :
	break;
case mnuCmdINPUT2_MIN_VOL :
	break;
case mnuCmdINPUT3_ACTIVE :
	break;
case mnuCmdINPUT3_NAME :
	break;
case mnuCmdINPUT3_MAX_VOL :
	break;
case mnuCmdINPUT3_MIN_VOL :
	break;
case mnuCmdINPUT4_ACTIVE :
	break;
case mnuCmdINPUT4_NAME :
	break;
case mnuCmdINPUT4_MAX_VOL :
	break;
case mnuCmdINPUT4_MIN_VOL :
	break;
case mnuCmdINPUT5_ACTIVE :
	break;
case mnuCmdINPUT5_NAME :
	break;
case mnuCmdINPUT5_MAX_VOL :
	break;
case mnuCmdINPUT5_MIN_VOL :
	break;
case mnuCmdINPUT6_ACTIVE :
	break;
case mnuCmdINPUT6_NAME :
	break;
case mnuCmdINPUT6_MAX_VOL :
	break;
case mnuCmdINPUT6_MIN_VOL :
	break;
case mnuCmdIR_ONOFF :
	break;
case mnuCmdIR_UP :
	break;
case mnuCmdIR_DOWN :
	break;
case mnuCmdIR_REPEAT :
	break;
case mnuCmdIR_LEFT :
	break;
case mnuCmdIR_RIGHT :
	break;
case mnuCmdIR_SELECT :
	break;
case mnuCmdIR_BACK :
	break;
case mnuCmdIR_MUTE :
	break;
case mnuCmdIR_PREV :
	break;
case mnuCmdIR_1 :
	break;
case mnuCmdIR_2 :
	break;
case mnuCmdIR_3 :
	break;
case mnuCmdIR_4 :
	break;
case mnuCmdIR_5 :
	break;
case mnuCmdIR_6 :
	break;
case mnuCmdTRIGGER1_ACTIVE :
	break;
case mnuCmdTRIGGER1_TYPE :
	break;
case mnuCmdTRIGGER1_ON_DELAY :
	break;
case mnuCmdTRIGGER1_TEMP :
	break;
case mnuCmdTRIGGER2_ACTIVE :
	break;
case mnuCmdTRIGGER2_TYPE :
	break;
case mnuCmdTRIGGER2_ON_DELAY :
	break;
case mnuCmdTRIGGER2_TEMP :
	break;
case mnuCmdTRIGGER_INACT_TIMER :
	break;
case mnuCmdDISP_SAVER_ACTIVE :
	break;
case mnuCmdDISP_ON_LEVEL :
	break;
case mnuCmdDISP_DIM_LEVEL :
	break;
case mnuCmdDISP_DIM_TIMEOUT :
	break;
case mnuCmdDISP_VOL :
	break;
case mnuCmdDISP_INPUT :
	break;
case mnuCmdDISP_TEMP1 :
	break;
case mnuCmdDISP_TEMP2 :
	break;
case mnuCmdABOUT :
	break;
case mnuCmdSAVE_CUST :
	break;
case mnuCmdLOAD_CUST :
	break;
case mnuCmdLOAD_DEFAULT :
	break;
*/

/*
<?xml version="1.0"?>
<RootMenu xmlns:xsi="http://www.w3.org/2001/XMLSchema-instance" 
    xmlns:xsd="http://www.w3.org/2001/XMLSchema">
    <Config IdPrefix="mnuCmd" VarPrefix="ctlMenu" UseNumbering="false" IncludeNumberHierarchy="false" MaxNameLen="15" MenuBackFirstItem="false" BackText="Back" ExitText="Exit" AvrProgMem="false"/>
    <MenuItems>
        <Item Id="VOLUME_MENU" Name="Volume">
            <MenuItems>
                <Item Id="VOL_STEPS" Name="Volume steps"/>
                <Item Id="MIN_ATT" Name="Min attenuation"/>
                <Item Id="MAX_ATT" Name="Max attenuation"/>
                <Item Id="MAX_START_VOL" Name="Max start vol"/>
                <Item Id="MUTE_LVL" Name="Mute level"/>
                <Item Id="STORE_LVL" Name="Vol. memory"/>
            </MenuItems>
        </Item>
        <Item Id="INPUT_MENU" Name="Inputs">
            <MenuItems>
                <Item Id="INPUT1_MENU" Name="Input 1">
                    <MenuItems>
                        <Item Id="INPUT1_ACTIVE" Name="Active"/>
                        <Item Id="INPUT1_NAME" Name="Name"/>
                        <Item Id="INPUT1_MAX_VOL" Name="Max. volume"/>
                        <Item Id="INPUT1_MIN_VOL" Name="Min. volume"/>
                    </MenuItems>
                </Item>
                <Item Id="INPUT2_MENU" Name="Input 2">
                    <MenuItems>
                        <Item Id="INPUT2_ACTIVE" Name="Active"/>
                        <Item Id="INPUT2_NAME" Name="Name"/>
                        <Item Id="INPUT2_MAX_VOL" Name="Max. volume"/>
                        <Item Id="INPUT2_MIN_VOL" Name="Min. volume"/>
                    </MenuItems>
                </Item>
                <Item Id="INPUT3_MENU" Name="Input 3">
                    <MenuItems>
                        <Item Id="INPUT3_ACTIVE" Name="Active"/>
                        <Item Id="INPUT3_NAME" Name="Name"/>
                        <Item Id="INPUT3_MAX_VOL" Name="Max. volume"/>
                        <Item Id="INPUT3_MIN_VOL" Name="Min. volume"/>
                    </MenuItems>
                </Item>
                <Item Id="INPUT4_MENU" Name="Input 4">
                    <MenuItems>
                        <Item Id="INPUT4_ACTIVE" Name="Active"/>
                        <Item Id="INPUT4_NAME" Name="Name"/>
                        <Item Id="INPUT4_MAX_VOL" Name="Max. volume"/>
                        <Item Id="INPUT4_MIN_VOL" Name="Min. volume"/>
                    </MenuItems>
                </Item>
                <Item Id="INPUT5_MENU" Name="Input 5">
                    <MenuItems>
                        <Item Id="INPUT5_ACTIVE" Name="Active"/>
                        <Item Id="INPUT5_NAME" Name="Name"/>
                        <Item Id="INPUT5_MAX_VOL" Name="Max. volume"/>
                        <Item Id="INPUT5_MIN_VOL" Name="Min. volume"/>
                    </MenuItems>
                </Item>
                <Item Id="INPUT6_MENU" Name="Input 6">
                    <MenuItems>
                        <Item Id="INPUT6_ACTIVE" Name="Active"/>
                        <Item Id="INPUT6_NAME" Name="Name"/>
                        <Item Id="INPUT6_MAX_VOL" Name="Max. volume"/>
                        <Item Id="INPUT6_MIN_VOL" Name="Min. volume"/>
                    </MenuItems>
                </Item>
            </MenuItems>
        </Item>
        <Item Id="IR_MENU" Name="Learn IR">
            <MenuItems>
                <Item Id="IR_ONOFF" Name="On/Off"/>
                <Item Id="IR_UP" Name="Up"/>
                <Item Id="IR_DOWN" Name="Down"/>
                <Item Id="IR_REPEAT" Name="Repeat"/>
                <Item Id="IR_LEFT" Name="Left"/>
                <Item Id="IR_RIGHT" Name="Right"/>
                <Item Id="IR_SELECT" Name="Select"/>
                <Item Id="IR_BACK" Name="Back"/>
                <Item Id="IR_MUTE" Name="Mute"/>
                <Item Id="IR_PREV" Name="Previous"/>
                <Item Id="IR_1" Name="1"/>
                <Item Id="IR_2" Name="2"/>
                <Item Id="IR_3" Name="3"/>
                <Item Id="IR_4" Name="4"/>
                <Item Id="IR_5" Name="5"/>
                <Item Id="IR_6" Name="6"/>
            </MenuItems>
        </Item>
        <Item Id="PWR_CTL_MENU" Name="Triggers">
            <MenuItems>
                <Item Id="TRIG1_MENU" Name="Trigger 1">
                    <MenuItems>
                        <Item Id="TRIGGER1_ACTIVE" Name="Active"/>
                        <Item Id="TRIGGER1_TYPE" Name="Moment./Latch"/>
                        <Item Id="TRIGGER1_ON_DELAY" Name="On delay"/>
                        <Item Id="TRIGGER1_TEMP" Name="Temp control"/>
                    </MenuItems>
                </Item>
                <Item Id="TRIG2_MENU" Name="Trigger 2">
                    <MenuItems>
                        <Item Id="TRIGGER2_ACTIVE" Name="Active"/>
                        <Item Id="TRIGGER2_TYPE" Name="Moment./Latch"/>
                        <Item Id="TRIGGER2_ON_DELAY" Name="On delay"/>
                        <Item Id="TRIGGER2_TEMP" Name="Temp control"/>
                    </MenuItems>
                </Item>
                <Item Id="TRIGGER_INACT_TIMER" Name="Standby timer"/>

            </MenuItems>
        </Item>
        <Item Id="DISP_MENU" Name="Display">
            <MenuItems>
                <Item Id="DISP_SAVER_ACTIVE" Name="Screen saver"/>
                <Item Id="DISP_ON_LEVEL" Name="On Level"/>
                <Item Id="DISP_DIM_LEVEL" Name="Dim Level"/>
                <Item Id="DISP_DIM_TIMEOUT" Name="Timeout"/>
                <Item Id="DISP_VOL" Name="Volume display"/>
                <Item Id="DISP_INPUT" Name="Input display"/>
                <Item Id="DISP_TEMP1" Name="Temp 1 display"/>
                <Item Id="DISP_TEMP2" Name="Temp 2 display"/>
            </MenuItems>
        </Item>
        <Item Id="ABOUT" Name="About"/>
        <Item Id="RESET_MENU" Name="Save/load/reset">
            <MenuItems>
                <Item Id="SAVE_CUST" Name="Save user setup"/>
                <Item Id="LOAD_CUST" Name="Load user setup"/>
                <Item Id="LOAD_DEFAULT" Name="Factory reset"/>
            </MenuItems>
        </Item>
    </MenuItems>
</RootMenu>

*/
#endif
