Gninnorg/Gninnorg-Mezmerize-B1-ESP32-Controller/(commit log)

2019-11-24 added muses arduino library
2019-12-10 RelayController - First draft
2019-12-11 Changes to RelayController
2019-12-14 Added schematic, pcb-layout and 3D views of pcb to the folder "hardware"
2020-01-19 RelayController and Rotary Encoder
2020-01-20 Version 3 with JST-XH connectors
    Relay +/- corrected, fly back diodes added, two LEDs with resistors added to indicate +8V and +12V from PSU, pinheaders changed to JST-XH connectors
2020-01-21 changes to relay controller
2020-01-27 added IR and 2nd rotary encoder
2020-01-28 Added photo of Mezmerize input relay connector
2020-01-28 Changes ports for rotary encoder 2
2020-02-02 Expanded main to switch all relays
2020-02-02 Added test of relays
2020-02-03 Added test of LDR circuit to measure if power amp is on or off
2020-02-03 Updated to reflect pcbs received 2020.01.31
2020-02-05 staged changes
2020-02-09 Clean up of RelayController and created function for temperature measurement
2020-02-12 Control relays from rotary encoder
2020-02-18 Added function for temperature display
2020-02-18 Temperature checked every 30 seconds
2020-02-23 Input names with upper and lower case
2020-02-29 Fix temp measurement and power loss handling
    [main.cpp]
2020-03-03 Rollback to avoid memory problems :-(
    [MenuData.h, main.cpp]
2020-03-04 Memory problem solved (again :-)
    [MenuData.h, main.cpp]
2020-03-05 Ready to implement volume and relay control
2020-03-06 Errors fixed - stable but issue with calc of att
    [main.cpp]
2020-03-07 Smaller fixes after testing
    [main.cpp]
2020-03-07 Further fixes and validation
    [main.cpp]
2020-03-08 Bug fix: Added check for received IR_PREVIOUS
    [main.cpp]
2020-03-10 Added auto shutdown if temperature is too high
    [main.cpp]
2020-05-27 Fixed volume att & input settings
    [main.cpp]
2020-06-03 Fixed error infinite loop in input selection
    [main.cpp]
2020-06-06 Fixed error when changing inputs
    [main.cpp]
2020-06-08 Strangely this line solves the problem with double reads
    [main.cpp]
2020-06-09 //Often the IR remote is to sensitive, reset reading if its to fast, but only if IR code is not REPEAT
    [main.cpp]
2020-06-17 Fixed issue in relation to IR ONOFF
    [main.cpp]
2020-06-21 Fix: select input on startup, mute at standby
    [main.cpp]
2020-06-25 Fix: keep screen turned off during standby
    [main.cpp]
2022-01-20 change libraries IR & ENCODER
2022-02-02 Changed pin numbers to map to the ESP32 pins
2022-02-21 And final traces of PROGMEM use removed
2022-02-21 Added BOM.xlsx
    [BOM.xlsx]
2022-03-30 schematic updated
    [Mezmerize_B1_Controller.kicad_pcb, Mezmerize_B1_Controller.kicad_sch, Mezmerize_B1_Controller.sch]
2022-04-03 Schematic cleanup
    [Mezmerize_B1_Controller.kicad_sch]
2022-04-06 schenatics + symbols
    [Mezmerize_B1_Controller.kicad_pcb]
2022-04-06 Update to new esp32 symbol
    [Mezmerize_B1_Controller.kicad_sch]
2022-04-10 Don't send KiCad backup to git
2022-04-10 Last attempt .gitignore - now its working
    [Mezmerize_B1_Controller.kicad_sch]
2022-05-04 PCB split
    [Mezmerize_B1_Controller.kicad_pcb, Mezmerize_B1_Controller.kicad_sch]
2022-05-04 Split pcb
    [Power Supply.kicad_pcb, Power Supply.kicad_sch, Power Supply.sch, Power_Supply.kicad_sch]
2022-05-18 psu pcb ready
    [Power Supply-B_Cu.gbl, Power Supply-B_Mask.gbs, Power Supply-B_Paste.gbp, Power Supply-B_Silkscreen.gbo, Power Supply-Edge_Cuts.gm1, Power Supply-F_Cu.gtl, Power Supply-F_Mask.gts, Power Supply-F_Paste.gtp]
2022-06-01 Missing changes ??
    [Mezmerize_B1_Controller.kicad_pcb, Mezmerize_B1_Controller.kicad_sch]
2022-06-01 mod psu + control v 0.25
    [Mezmerize_B1_Controller.kicad_pcb, Mezmerize_B1_Controller.kicad_sch, Power Supply.kicad_pcb]
2022-08-17 updated pcb
    [Mezmerize_B1_Controller.kicad_pcb]
2022-08-24 Opdater print
    [Mezmerize_B1_Controller-B_Cu.gbl, Mezmerize_B1_Controller-B_Mask.gbs, Mezmerize_B1_Controller-B_Paste.gbp, Mezmerize_B1_Controller-B_Silkscreen.gbo, Mezmerize_B1_Controller-Edge_Cuts.gm1, Mezmerize_B1_Controller-F_Cu.gtl, Mezmerize_B1_Controller-F_Mask.gts, Mezmerize_B1_Controller-F_Paste.gtp]
2022-08-31 BOM created
    [Mezmerize_B1_Controller.csv]
2022-09-24 Updated footprint of eeprom to show orientation (leg 1)
    [Mezmerize_B1_Controller.kicad_pcb]
2022-09-28 Changed union for eeprom and NTC resistance
2022-11-20 Fixed min definition in .h file
    [main.cpp]
2023-02-05 Add control of power relay (D4)
2023-02-06 Power relay + wifi adjustments
2023-02-09 Temperature update (precision adc)
2023-02-15 Fixed temp measurement + display temp
    [main.cpp]
2023-02-18 Changed calibration + index.html
2023-02-25 Fixed chrash when client connected (typo)
    [main.cpp]
2023-02-27 Fixed Power toggle from Websocket crashed Asyncftp
    [main.cpp]
2023-03-01 Added calibration for Jan's ESP32
2023-03-01 Fixed display corruption (chng volume screensaver)
    [main.cpp]
2023-03-30 minor bug fixed in getAttenuation
    [main.cpp]
